kksjunior/Arduino-LED-Matrix/README.md

# Arduino-LED-Matrix-Code
In this Repository you will find codes for driving the LED Matrix made using the Arduino development board as mentioned in the article below.

https://www.instructables.com/id/48-X-8-Scrolling-LED-Matrix-Using-Arduino/
