kksjunior/Arduino-LED-Matrix/(commit log)

2017-09-15 Add files via upload
    Code for 48 x 8 Scrolling LED Display
2017-09-15 Add files via upload
    LED Scrolling Matrix Display using 4017 Decade Counter
